iamazizhaider/smart_home_automation/Designs/Block Diagram.pdf

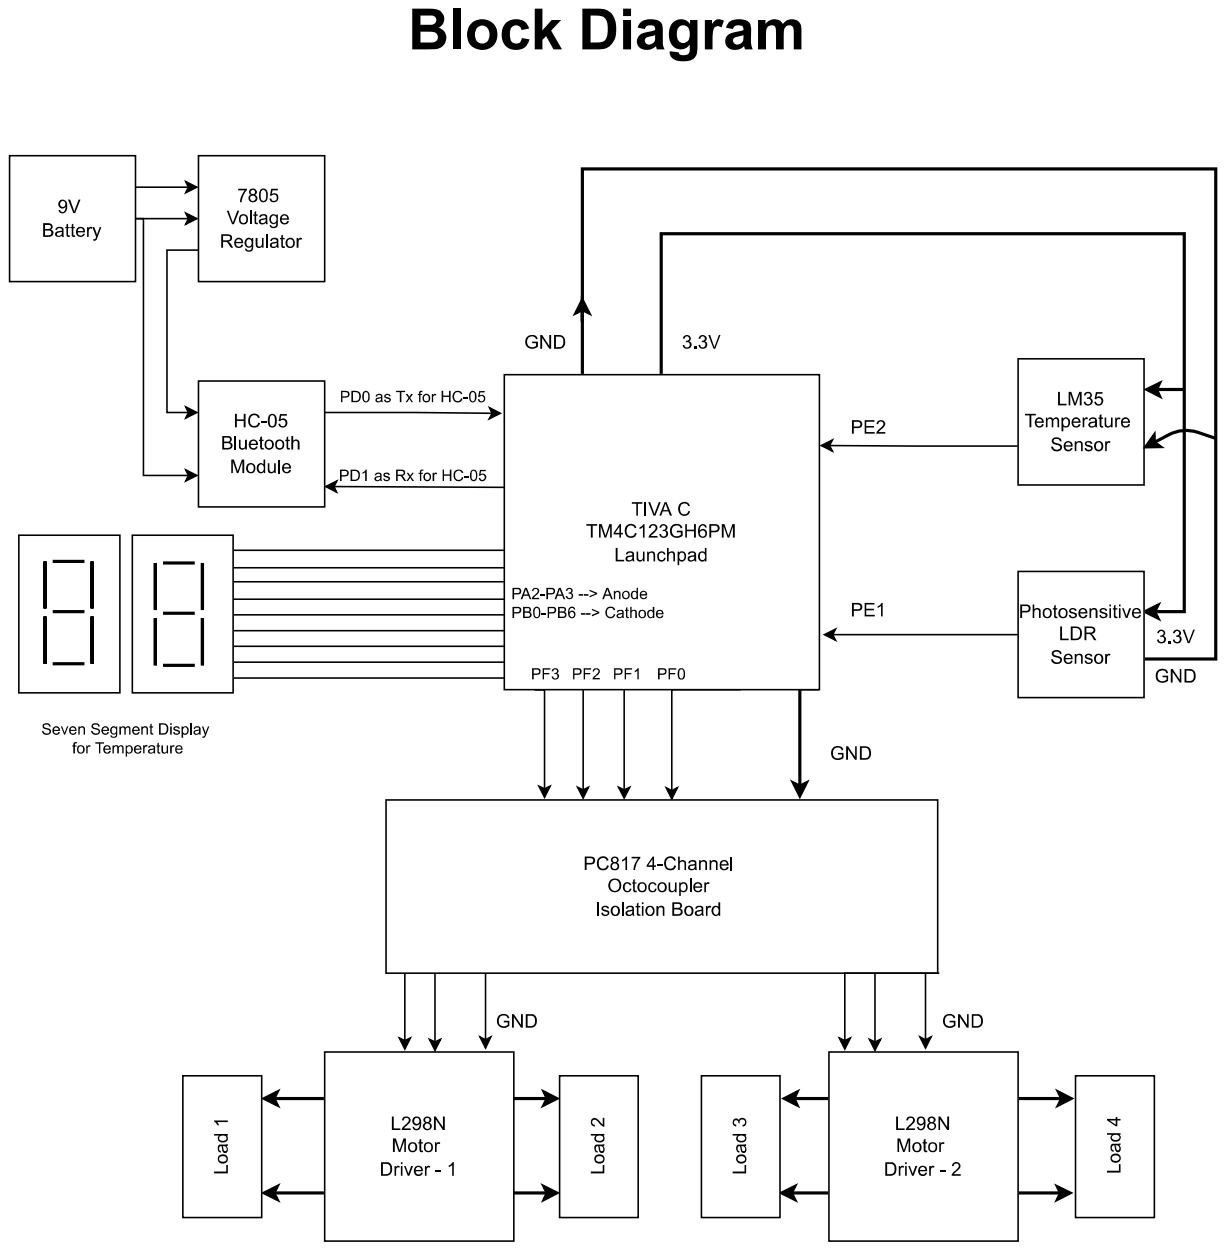
[picture p1: page 1]
