iamazizhaider/smart_home_automation/Designs/Circuit Diagram.pdf

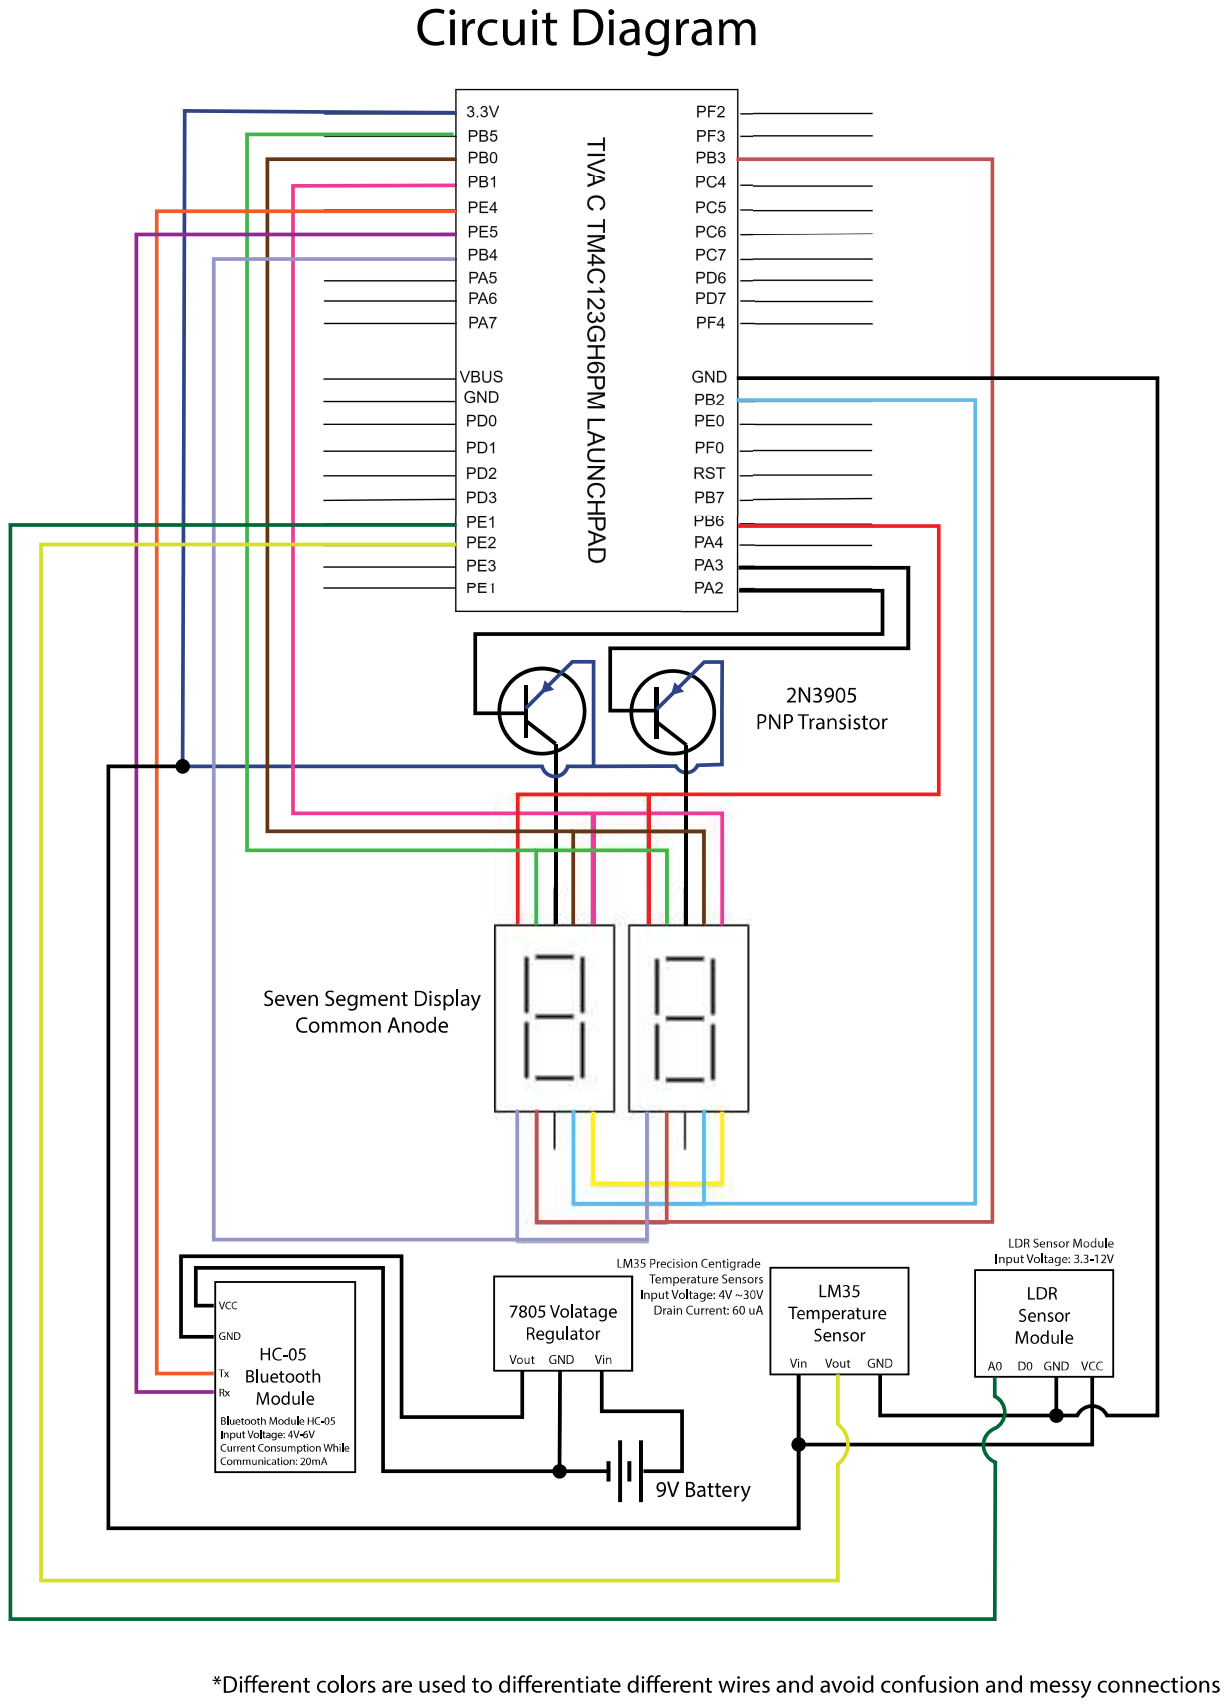
[picture p2: page 1]

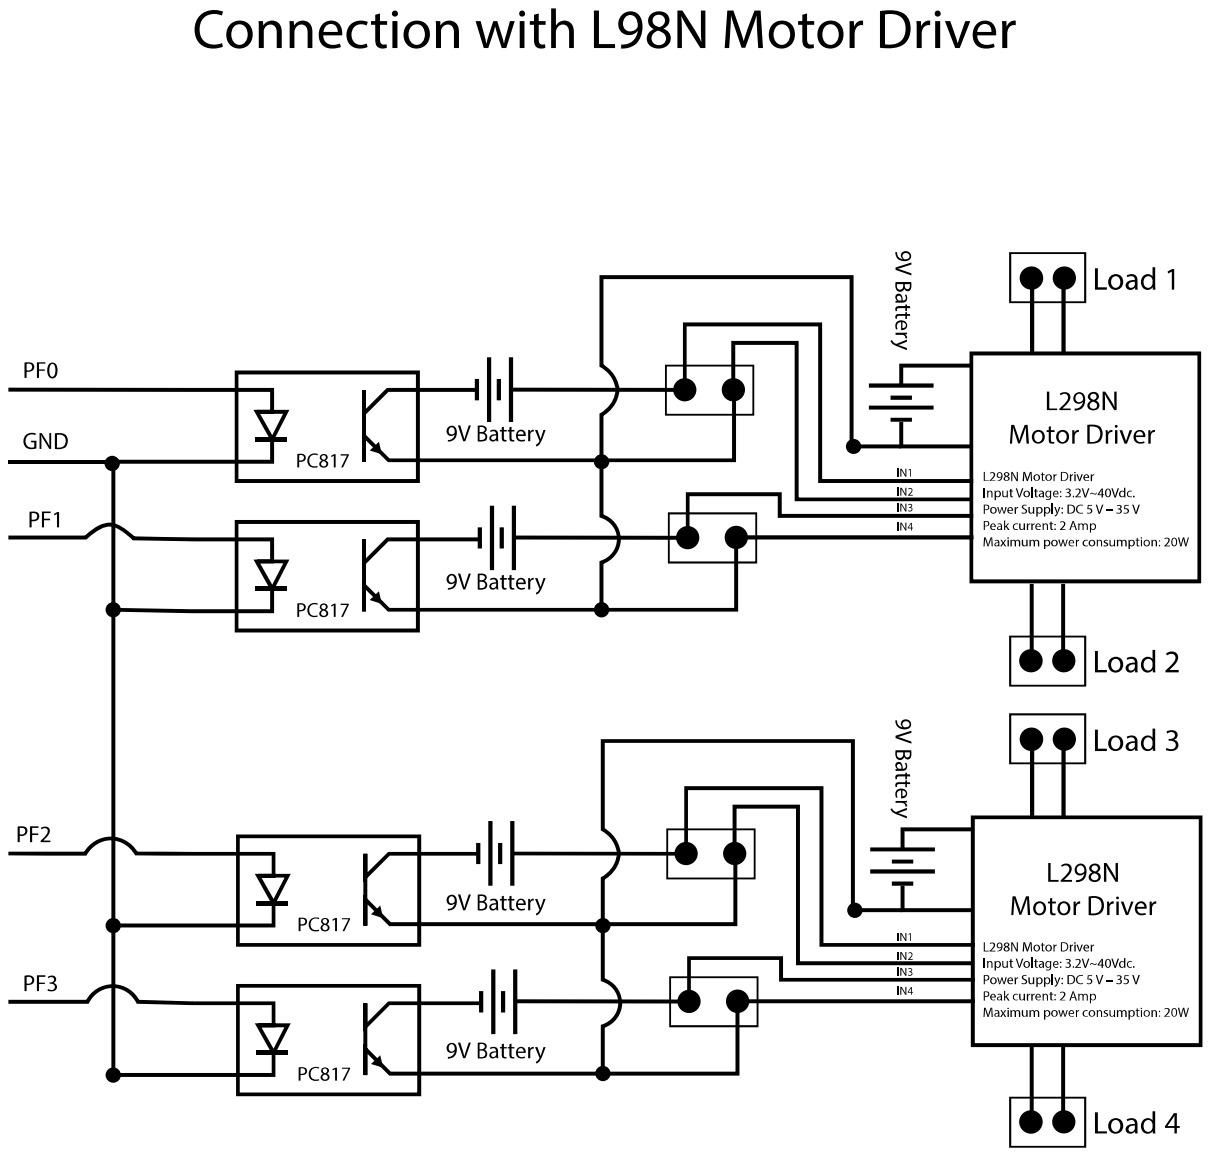
[picture p3: page 2]

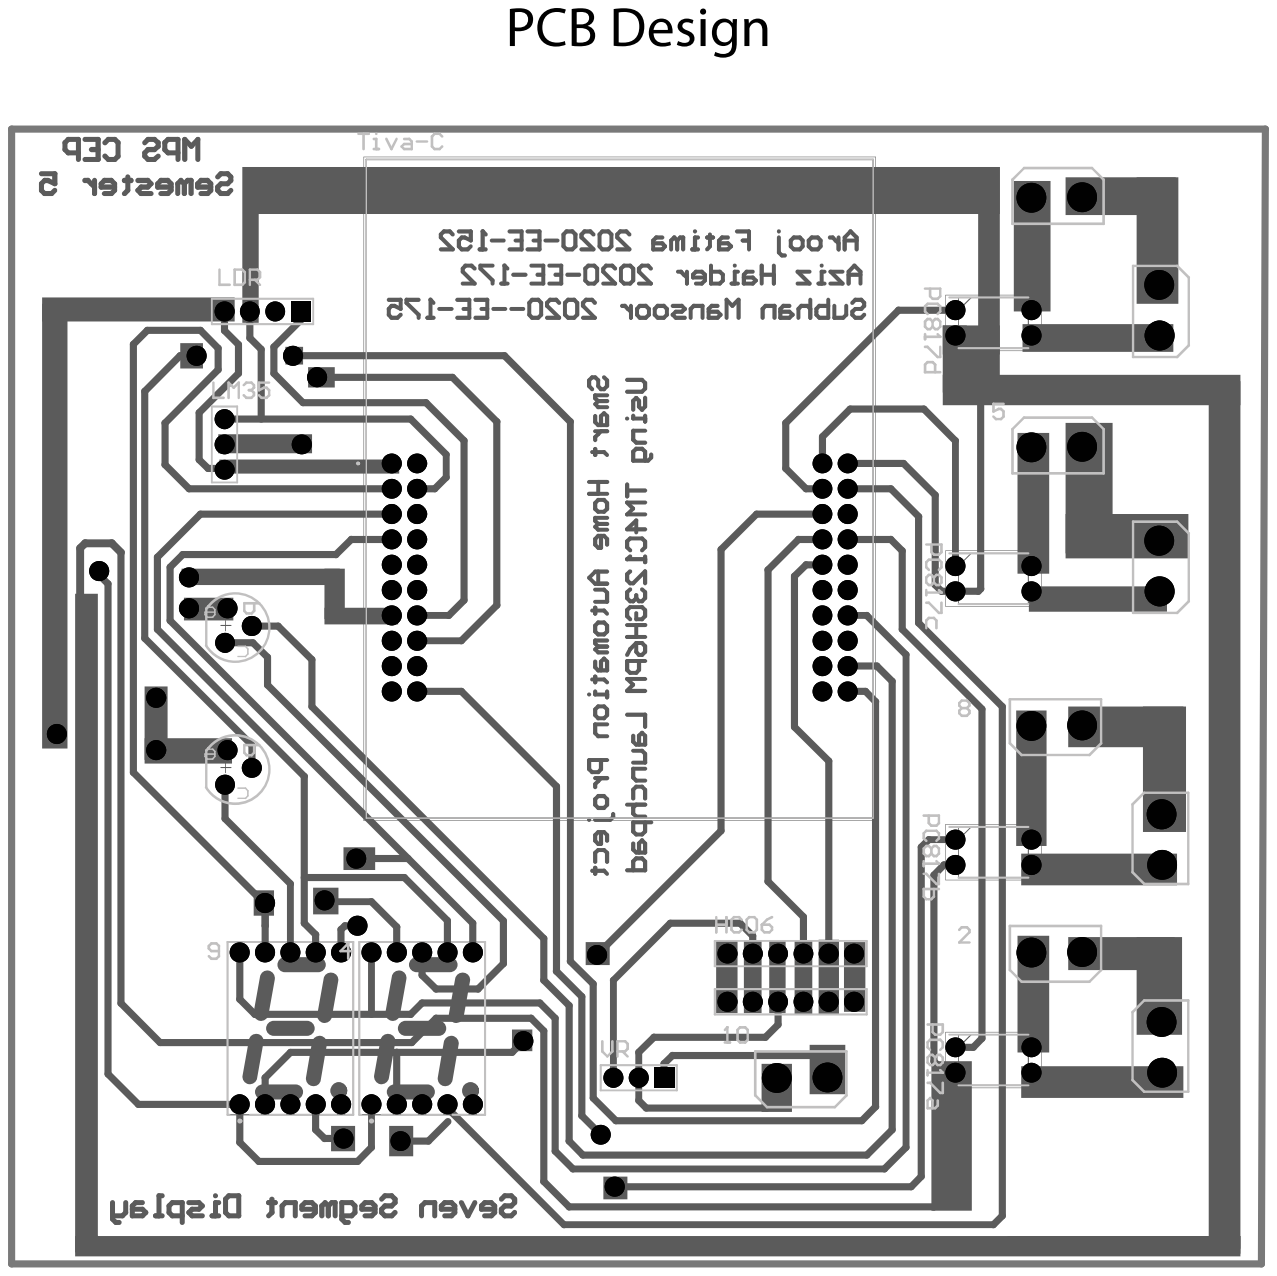
[picture p4: page 3]
