iamazizhaider/smart_home_automation/(list of files, drawings)

Other design files:
Designs/PCB_Design.PcbDoc
